sonjyolo1-cyber/embedded-automotive-control/docs/design.md

# Design: turn signal & hazard controller

Target: EK-TM4C123GXL LaunchPad (TM4C123GH6PM, Cortex-M4F), register-level C, no TivaWare.
Host tests: GCC 14.2 (MSYS2 UCRT64) + Unity.

Status: Phase 5 (verification) done, tag v0.5. Phase 6: buzzer (R11), watchdog WDT0 and cppcheck done.

---

## 1. Hardware

### Pin map

| Signal | Pin | Direction | Notes |
|---|---|---|---|
| Front-left lamp | PE0 | output | LED + series resistor to GND, active-high |
| Rear-left lamp | PE1 | output | |
| Front-right lamp | PE2 | output | |
| Rear-right lamp | PE3 | output | |
| Buzzer (R11) | PE4 | output | passive buzzer driven by a 2N2222 (low side, base resistor), 1N4148 across the buzzer; 1 = transistor on |
| LEFT button | PB0 | input | to GND, internal pull-up, active-low |
| RIGHT button | PB1 | input | to GND, internal pull-up, active-low |
| HAZARD button | PB2 | input | to GND, internal pull-up, active-low |
| UART0 RX / TX | PA0 / PA1 | alt. function 1 | LaunchPad virtual COM port (debug USB) |

Buttons are wired straight to GND (no external resistor). A loose resistor in this path caused
intermittent contact during bring-up (see devlog).

### Clock

`SystemCoreClock` = **50 MHz** (PLL configured by `SystemInit` in the startup code).
All timing derives from it at run time, nothing hard-codes 16 MHz.

---

## 2. Timing

| Item | Value | Why |
|---|---|---|
| SysTick tick | 1 ms | one shared time base for all tasks |
| Tick storage | `volatile uint32_t g_ticks` counter (not a flag) | a flag loses ticks if `main` is busy > 1 ms; a counter does not |
| Elapsed time | `(now - last) >= N` | correct across the 32-bit wrap (~49.7 days); `now >= last + N` is not |
| Debounce window | 20 ms | measured bounce max 4-5 ms (20 presses, 40/40 bursts): 4x margin, well under ~50 ms a user notices |
| Blink | 1.5 Hz, 333 ms half period | `last += 333` after each toggle, so lateness does not accumulate |

ISRs do one thing only (SysTick: `g_ticks++`). All work happens in the `main` super-loop.

---

## 3. Buttons (debounce)

A button's clean state changes only after its pin shows **no edge (rising or falling) for 20 ms**.
Every edge restarts the timer.

Per-button state: `raw_prev`, `last_edge_ms` (`uint32_t`, same type as `g_ticks`), `stable`, `pressed_event`.
Initial values come from a real pin read, so a button held during reset gives no event.

API: `buttons_update(now_ms)` every loop pass; `button_is_pressed()` = clean state;
`button_was_pressed()` = one event per press, cleared on read. Time is passed in so the driver can be
unit-tested on a PC.

---

## 4. UART log

UART0, 115200 8N1, TX FIFO on. 50 MHz: `IBRD = 27`, `FBRD = 8` (actual 115207 baud, 0.006 % error),
computed at run time from `SystemCoreClock` in integer math: `brd_x64 = (clock*4 + baud/2) / baud`.

TX by polling: each log line fits (or nearly fits) the 16-byte FIFO, so `main` barely waits.
Switch to interrupt + ring buffer if a single print grows beyond ~50 characters (~4 ms of waiting).

---

## 5. Turn signal state machine

Lives in `app/turn_signal.c`: pure C, no register headers, unit-tested on the PC.

### Decisions

1. **Toggle.** Pressing the button of the side that is already on turns it off.
   Momentary buttons have no centre position like a real stalk, and no extra OFF button is needed.
2. **Hazard has the highest priority.** While hazard is on, LEFT/RIGHT never change the lamps.
   A safety function must not be cancelled by an accidental press.
3. **Virtual stalk.** While hazard is on, LEFT/RIGHT still move a remembered stalk position
   (`resume_state`) through the same toggle table. Pressing HAZARD again returns to it,
   like a real car whose latched stalk takes over when hazard goes off.
   - Chosen over "always return to OFF" because it matches real driver expectations.
   - Chosen over separate `HAZARD_FROM_x` states because it scales: new modes add one state, not one per mode.
   - Toggle (not "set") for the virtual stalk: the driver can still cancel the remembered side during hazard,
     and a button means the same thing at all times.

### Stalk table (toggle)

| stalk \ press | LEFT | RIGHT |
|---|---|---|
| **OFF** | LEFT | RIGHT |
| **LEFT** | OFF | RIGHT |
| **RIGHT** | LEFT | OFF |

### Full behaviour

| In state | Event | New state | `resume_state` after |
|---|---|---|---|
| OFF / LEFT / RIGHT | LEFT or RIGHT | stalk table | unchanged |
| OFF | HAZARD | HAZARD | OFF |
| LEFT | HAZARD | HAZARD | LEFT |
| RIGHT | HAZARD | HAZARD | RIGHT |
| HAZARD | LEFT | HAZARD | stalk table(`resume_state`, LEFT) |
| HAZARD | RIGHT | HAZARD | stalk table(`resume_state`, RIGHT) |
| HAZARD | HAZARD | `resume_state` | unchanged |

### Implementation

- `typedef struct { state_t state; state_t resume_state; } turn_signal_t;`
- Stalk table as a `static const` 3 x 2 lookup array (lives in flash). HAZARD handled by `if` logic
  because it reads and writes `resume_state`.
- Guards: out-of-range event or corrupted state leaves the struct unchanged. C does not check array
  bounds; an unchecked index would silently read another cell or memory outside the table.
- `*_COUNT` enum members size the arrays. Enum order matters: `STATE_HAZARD` / `EVENT_HAZARD`
  follow the stalk states / events.

### Open points

- ~~Two button events in the same loop pass: processing order changes the result for LEFT + RIGHT.~~
  Resolved (2026-10-18), see "LEFT + RIGHT conflict" below.
- "Tap = blink 3 times" (Phase 6) is a conditional transition and will not fit the lookup table alone.

### LEFT + RIGHT conflict

A hand laid across both buttons is a mistake, not a command. Two fingers rarely land in the same 1 ms
loop pass; they usually differ by a few to tens of ms, so checking only "same pass" would almost never fire.

1. **React at once, the later button loses.** A LEFT press while RIGHT is held (debounced level,
   `button_is_pressed`) is dropped, and the other way round. The first button has already acted.
   - Chosen over "wait ~50 ms, then drop both": every normal press would be delayed, and the driver
     can fix a wrong side by pressing again.
2. **Same pass, both edges: drop both.** Neither came first, so nothing happens.
   - Coded as its own check (2026-10-18), not left to rule 1. Today the driver sets "held" in the same
     pass as "pressed", so rule 1 alone would also drop both; the own check keeps rule 2 true if the
     driver changes (e.g. `buttons_update` moved into the SysTick ISR).
3. **HAZARD is never in conflict.** It is passed through; HAZARD + LEFT gives the same result in either order (tested).
4. During hazard the same rule applies, so a conflict does not move `resume_state` either (Claude's call).
5. **Pure function in `app/`**, unit tested on the PC: `press_filter_events(&in, ev)` in `app/press_filter.c`.
   `press_filter_in_t` holds "pressed this pass" (`button_was_pressed`) for LEFT, RIGHT, HAZARD and "held now"
   (`button_is_pressed`) for LEFT, RIGHT. It writes the events to `ev[EVENT_COUNT]` in the fixed order
   LEFT, RIGHT, HAZARD and returns how many (0..3); `in` or `ev` NULL returns 0. `main.c` only reads the
   buttons and forwards each event to `turn_signal_step`.
6. **"Pressed but already released" cannot happen with the current driver.** `buttons_update` and the reads
   run in the same pass, so `pressed = 1` always comes with `held = 1`; a stalled `main` also stalls
   `buttons_update`, so a press and release during a stall is missed, not seen as pressed-but-released.

---

## 5b. Blink logic

Lives in `app/blink.c`: pure C, unit-tested on the PC with fake ticks (each test passes `now_ms` by hand).

### Decisions

1. **Input = `state` + `now_ms`.** `main` reads `g_ticks` and passes the value in; the module never reads
   `g_ticks` itself, so it links and runs on the PC. It does not see buttons: `turn_signal` already turned
   presses into `state` (e.g. LEFT during hazard leaves `state` = HAZARD, so blink needs no extra rule).
2. **Output = on/off per side** (`blink_out_t { left, right }`), not one on/off value.
   Every decision (which side follows the phase) is inside tested code; `main` only writes the result.
3. **Memory:** `prev_state` (detect a state change, same idea as `raw_prev` in the button driver),
   `last_ms` (start of the current phase), `phase_on` (no register to toggle, so the module keeps the phase).
4. **State change restarts the phase ON**, counted from that moment. The lamp lights at once; a delay of up to
   333 ms could make the driver press again, which with toggle semantics would switch the signal off.
5. **Phase flips with `last_ms += 333`** (fixed grid, no drift, wrap-around safe), at most one flip per call.

| state | left | right |
|---|---|---|
| OFF | 0 | 0 |
| LEFT | `phase_on` | 0 |
| RIGHT | 0 | `phase_on` |
| HAZARD | `phase_on` | `phase_on` |

API: `blink_init(&b, now_ms)` (starts as if OFF, so the first press counts as a change);
`blink_out_t blink_update(&b, state, now_ms)` once per loop pass. Corrupted state -> `{0, 0}`.

### Risks

- After `main` stalls (breakpoint, long UART print), consecutive calls flip the phase several times within
  microseconds until `last_ms` catches up with the grid. Final phase is correct and invisible on LEDs, but a
  buzzer that clicks on every flip would click several times: revisit in Phase 5.
  Resolved in 5c: the buzzer only restarts its pulse on edges in the same ms, so the catch-up gives one click.
- If `main` forgets to call `blink_update` every pass, the lamps freeze: checked on the board.

---

## 5c. Buzzer (R11)

Lives in `app/buzzer.c`: pure C, unit-tested on the PC with fake ticks, like blink.

### Decisions

1. **Input = lamp output, not `ts.state`.** `main` passes `out.left || out.right` from `blink_update`, so the
   buzzer is silent in OFF, clicks at once when a signal starts, and HAZARD (both sides in the same rhythm)
   gives one click per edge, not two.
2. **Short pulse at every lamp edge (on and off), pin 0 the rest of the time.** A passive buzzer only clicks
   when the coil current changes. Holding the pin at 1 for the whole 333 ms phase would pass ~200 mA
   (3.3 V / 16 ohm) without a louder click.
3. **`BUZZER_PULSE_MS = 2`.** The tick is 1 ms, so the real pulse is 1 to 2 ms; 1 could be ~0 ms. Tuned by ear.
4. **Edges in the same ms restart the pulse**, so blink catching up after a stalled `main` gives one click.
5. **Hardware:** PE4 cannot drive the coil, so a 2N2222 switches it on the low side; the 1N4148 across the
   buzzer (cathode to +3.3 V) takes the coil's reverse spike when the transistor turns off.

API: `buzzer_init(&bz, now_ms)`; `uint8_t buzzer_update(&bz, lamp_on, now_ms)` once per loop pass, right after
`blink_update`; `main` writes the result with `lamp_set(LAMP_BUZZER, ...)`. NULL -> 0 (coil off).

### Risks

- An **active** buzzer (own oscillator) would hardly sound with a 2 ms pulse: this design assumes a passive one.
- The 2N2222 in TO-92 comes as PN2222A (E-B-C) and P2N2222A (C-B-E): with E and C swapped it barely conducts.

---

## 5d. Watchdog (WDT0)

`app/watchdog.c/.h` (a hardware driver; to be moved to `firmware/`).

### Decisions

1. **Feed at the end of every main loop pass, never in an ISR.** SysTick keeps running when `main` hangs,
   so a feed in `SysTick_Handler` would keep the chip alive while lamps and buzzer are frozen
   (with PE4 possibly stuck at 1, ~200 mA through the coil).
2. **Time-out 500 ms.** Longest normal pass ~1 ms (a state line fits the 16-byte FIFO; the ~5 ms banner runs
   before the watchdog starts). 500 ms is about 1.5 blink cycles for the driver.
3. **Restart in OFF.** The normal init path; behaviour after a watchdog reset equals power-on.
4. **WDT0 resets on the second time-out**, so `WDTLOAD = clock_hz / 1000 * timeout_ms / 2` (12 500 000 at 50 MHz).
   Divide first: `50e6 * 500` would overflow 32 bits.
5. **`WDTTEST.STALL` set**: the counter stops while a debugger halts the CPU.
6. **`RESEN` before `INTEN`**: configure, then start (`INTEN` is write-once until the next reset).
   WDT interrupt not enabled in the NVIC; `WDTLOCK` not used.
7. **Reset cause** read from `RESC` first thing in `main`, logged, then cleared (sticky bits).

### Risks

- A future loop pass close to 500 ms (for example a 200+ character print, ~17 ms, is still fine; a blocking
  delay of seconds is not) would cause false resets.
- Not using the first time-out interrupt: on a hang the outputs stay as they were for up to 500 ms.

---

## 6. Software structure

```
app/            pure C application logic, no hardware (turn_signal, blink, press_filter, buzzer);
                watchdog.c/.h also sits here for now but is a hardware driver (to move to firmware/)
firmware/       Keil project: startup, drivers (gpio, lamps, systick, buttons, uart), main.c
tests/          Unity tests run on the PC; tests/unity is a git submodule
docs/           design.md, devlog.md
build/          host test executables (git-ignored)
```

Data flow (planned for integration):

```
SysTick ISR -> g_ticks -> buttons_update() -> button_was_pressed() / button_is_pressed()
                                              -> press_filter_events() -> turn_signal_step()
                                                                      -> blink logic -> lamps
                                                                                     -> buzzer (PE4)
```

---

## 7. Tests

Host (`tests/test_turn_signal.c`, 17 tests, all pass):
stalk table (6), entering hazard (3), hazard priority (2), leaving hazard via virtual stalk (3),
HAZARD + LEFT in either order (1), input guards (2).

Host (`tests/test_blink.c`, 13 tests, all pass, fake ticks):
OFF all off, LEFT on at once / off at +333 / on at +666, RIGHT right side only, HAZARD both in sync,
LEFT -> RIGHT restarts the phase, LEFT -> OFF off at once, LEFT pressed during hazard keeps the rhythm,
catch-up after a 1000 ms stall, 32-bit tick wrap, corrupted state.

Host (`tests/test_press_filter.c`, 15 tests, all pass):
single button (4), later button loses while the other is held (2), both edges in the same pass with and
without held (2), HAZARD passes with LEFT / while both held / during a conflict (3), own held flag never
drops a press (1), RIGHT works again after LEFT released (1), NULL input / output (2).

Host (`tests/test_buzzer.c`, 11 tests, all pass, fake ticks):
basic edges (lamp off silent, on and off edge each give a pulse, any non-zero counts as on), failure cases
(edges in the same ms give one pulse, tick wrap, NULL), and with the real blink + turn_signal: LEFT clicks on
every lamp edge, OFF silent, HAZARD clicks once per edge, switching side while lit adds no extra click.

Build and run from the repo root:

```
gcc -std=c99 -Wall -Wextra -I tests/unity/src -I app tests/test_turn_signal.c app/turn_signal.c tests/unity/src/unity.c -o build/test_turn_signal.exe
build\test_turn_signal.exe

gcc -std=c99 -Wall -Wextra -I tests/unity/src -I app tests/test_blink.c app/blink.c app/turn_signal.c tests/unity/src/unity.c -o build/test_blink.exe
build\test_blink.exe

gcc -std=c99 -Wall -Wextra -I tests/unity/src -I app tests/test_press_filter.c app/press_filter.c tests/unity/src/unity.c -o build/test_press_filter.exe
build\test_press_filter.exe

gcc -std=c99 -Wall -Wextra -I tests/unity/src -I app tests/test_buzzer.c app/buzzer.c app/blink.c app/turn_signal.c tests/unity/src/unity.c -o build/test_buzzer.exe
build\test_buzzer.exe
```

Hardware checks done in Phase 3: 20 presses -> 20 events, 3 s hold -> 1 event, held during reset -> 0 events,
UART one line per press.
