sonjyolo1-cyber/embedded-automotive-control/project2/bluepill_body/clock.c

#include "clock.h"
#include "stm32f10x.h"

void clock_init()
{
	RCC->CR |= RCC_CR_HSEON;
	while (!(RCC->CR & RCC_CR_HSERDY)) {}
	
	FLASH->ACR = FLASH_ACR_PRFTBE | FLASH_ACR_LATENCY_2;
	
	RCC->CFGR |= (RCC_CFGR_PLLSRC_HSE | RCC_CFGR_PLLMULL9 | RCC_CFGR_PPRE1_DIV2);
		
	RCC->CR |= RCC_CR_PLLON;
	while (!(RCC->CR & RCC_CR_PLLRDY)) {}
	
	RCC->CFGR |= RCC_CFGR_SW_PLL;
	while ((RCC->CFGR & RCC_CFGR_SWS) != RCC_CFGR_SWS_PLL) {}
}
