sonjyolo1-cyber/embedded-automotive-control/(commit log)

2026-10-12 Phase 4 setup: Keil project into repo, Unity test framework
2026-10-17 Phase 4: press_filter design and interface (LEFT + RIGHT conflict)
    Decide how a LEFT/RIGHT press is handled while the other side is held:
    the later button loses, both edges in the same pass drop both, HAZARD
    always passes. Recorded in design.md section 5, plan for the module in
    docs/superpowers/plans. Header only; tests and implementation follow (TDD).
    Existing suites still pass: test_turn_signal 17/0, test_blink 13/0.
2026-10-18 Phase 4: press_filter drops LEFT/RIGHT while the other is held, 15 unit tests pass
    Pure function between the button driver and turn_signal_step: a LEFT/RIGHT
    press is dropped while the other side is held, both edges in the same pass
    drop both (coded on its own, not left to how the driver sets "held"),
    HAZARD always passes. Fixed output order LEFT, RIGHT, HAZARD. NULL in/out
    returns 0, same as turn_signal_step and blink_update.
    Written test first: red against a return-0 stub and against a version
    without the conflict rule; rule 2 and the NULL guard each red first.
    Host suites (-std=c99 -Wall -Wextra -pedantic, no warnings):
    smoke 2/0, turn_signal 17/0, blink 13/0, press_filter 15/0.
    Co-Aut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
2026-10-20 Phase 5: requirements updated to Phase 4 design (R12, R13), traceability table
    requirements.md: R4 (unless the active side is held), R5 (HAZARD again
    returns to the virtual stalk), R7 (one event per press, also when held),
    R9 (also with a button held during reset), R10 now optional after v1.1,
    new R12 (LEFT/RIGHT conflict) and R13 (virtual stalk during hazard).
    Decision 3 now points to R12; the I/O list points to the pin map in design.md.
    docs/test_plan.md: unit tests and board scenarios for every requirement,
    the R8 latency measurement method and its limits, and why R7's
    short-press part is not really checked yet.
    Host suites unchanged and passing: smoke 2/0, turn_signal 17/0,
    blink 13/0,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
2026-10-22 Phase 6: testing buzzer working alongside led phase rising and falling edge; 11 tests 0 failures
2026-10-24 Phase 6: buzzer integrated on PE4, R11 verified by ear
    main.c calls buzzer_update right after blink_update (input = lamp output,
    so OFF is silent and HAZARD clicks once per edge) and writes PE4 through
    lamp_set(LAMP_BUZZER, ...). buzzer.c/.h added to the Keil app group.
    Board: PE4 -> base resistor -> 2N2222 low side, passive buzzer, 1N4148
    across it. Silent buzzer and dead PB0 button were both a bad breadboard
    GND path, fixed with direct jumpers to a LaunchPad GND pin; no code change.
    docs: design.md section 5c (buzzer decisions, hardware, risks), pin map,
    structure, test list and build command; test_plan R11 PASS; devlog Phase 6.
    Host suites (-std=c99 -Wall -Wextra -pedantic): smoke 2/0,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
2026-10-29 Phase 6: watchdog WDT0 (500 ms, fed in main loop, STALL), reset cause logged; selftest passed
2026-10-30 Add missing watchdog driver sources
    watchdog.c/.h were referenced by the Phase 6 watchdog work but never tracked.
2026-11-02 Project 2: Buoi 1 - Learning about CAN Bus and design a wiring diagram to be later on
2026-11-06 Project 2: Buoi 2 - clock 72MHz, SysTick 1 ms, UART interrupt log (bare-metal)
